pthalin/snes_rgb_amplifier/sim/PAL_SNES_RGB_Amp_v1.asc

C1: cap; 10µ
C2: cap; 10µ
C4: cap; 47p
C: cap; 47p
D1: diode; DAN202K
D2: diode; DAN202K
D3: diode; DAN202K
D7: diode; DAN202K
D8: diode; DAN202K
D9: diode; DAN202K
Q1: pnp; 2SAR544P
Q2: npn; 2SC2412K
Q5: npn; BC817-40
Q7: pnp; 2SAR544P
Q8: npn; 2SC2412K
R0: res; 0.01
R1: res; 1k1
R2: res; 1k5
R4: res; 10k
R5: res; 10k
R10: res; 75
R11: res; 30
R20: res; 75
R21: res; 1k1
R22: res; 1k5
R24: res; 30
Ra: res; 27
Rb: res; 82
Rc: res; 75
V1: voltage; 5
Vgen: voltage; PULSE(1.5 3.8 0 1n 1n 180n 360n); Rser=30
Named nets: 5V, 0, Vsnes, Vrgb, V0rgb, V0snes
.tran 370n
0.7 Vpp
PAL SNES Model
RGB Amplifier
Standard Cable
TV
TV
